lsolcher/wobbly/3D-templates/box.obj

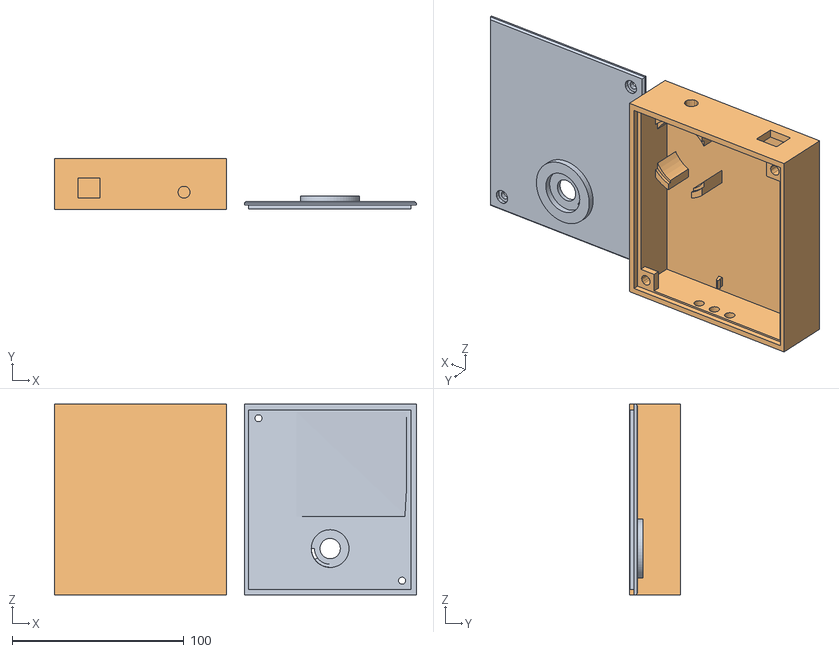
[picture p1: CAD file, 2018-02-02]
3D-templates/box.obj
210.6 x 29.6 x 111.1
