lsolcher/wobbly/3D-templates/knoppel.obj

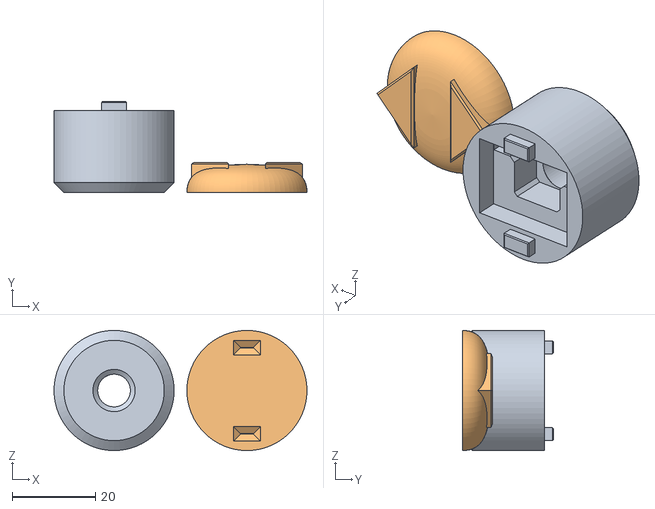
[picture p2: CAD file, 2018-02-02]
3D-templates/knoppel.obj
60.9 x 21.9 x 28.9
initialShadingGroup Line002
initialShadingGroup Object002
