lsolcher/wobbly/(commit log)

2018-01-29 add die logic
2018-02-02 update readme, add 3d templates, comment input module
    [box.obj, knoppel.obj]
